lesswater69/ikoka-stick-meshtastic-device/ikoka-stick-meshtastic-device.kicad_pcb

## KiCad design ikoka-stick-meshtastic-device.kicad_pcb (2025-10-22)

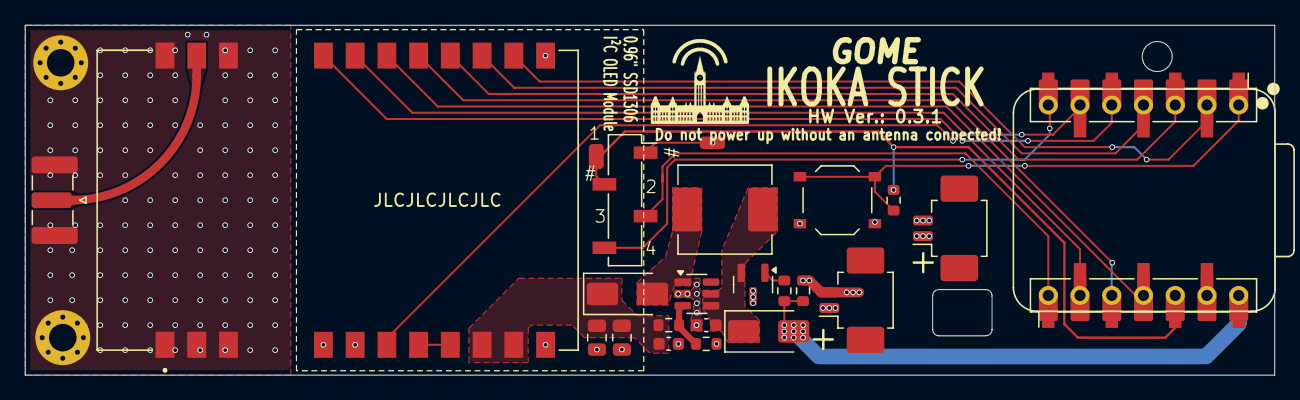
[picture p1: board ikoka-stick-meshtastic-device.kicad_pcb from above]

Board: 2 copper layers, 100.0 x 28.0 mm, 27 parts (1 on the bottom side), 22 nets.

Parts:
BT1: Battery_Cell; BatteryHolder_MYOUNG_BH-21700-B1BJ001_1x21700
C1, C2: 22uF; C_0603_1608Metric
C3, C4: 47uF; C_0805_2012Metric
D1, D3: SS34; D_SMA
H1, H2: MountingHole; MountingHole_2.2mm_M2_Pad_Via
J1: Conn_Coaxial; SMA_Samtec_SMA-J-P-H-ST-EM1_EdgeMount
J2, J3: Conn_01x07_Socket; PinSocket_1x07_P2.54mm_Vertical_SMD_Pin1Left
J4, J5: Conn_01x02; Molex_PicoBlade_53261-0271_1x02-1MP_P1.25mm_Horizontal
J6: Conn_01x04; PinSocket_1x04_P2.54mm_Vertical_SMD_Pin1Right
L1: 22uH; L_Sunlord_MWSA0624S
Q1: AO3401A; SOT-23
R1: 300K; R_0603_1608Metric
R2: 39K; R_0603_1608Metric
R3, R5: 100k; R_0603_1608Metric
R4: 1k; R_0603_1608Metric
SW1: SW_Push; SW_Push_1P1T_XKB_TS-1187A
U1: MT3608; SOT-23-6
U2: E22-900M30S; XCVR_E22-900M30S
U3: XIAO-ESP32-S3-SMD; XIAO-ESP32S3-DIP
pin1: SolderWirePad_1x01_SMD_1.5x3mm

Connections:
+3V3: J3.5, J6.2, R5.1, U3.12 (VCC_3V3), pin1.1
+5V: D3.2 (A), J3.7, R3.1, R4.1, U3.14 (VBUS)
+5V2_LORA: C2.1, C3.1, C4.1, D1.1 (K), R1.1, U2.9 (VCC), U2.10 (VCC)
+BATT: BT1.1 (+), J4.1, J5.1, Q1.3 (D)
/ANT: J1.1 (In), U2.21 (ANT)
/BOOST_IN: C1.1, D3.1 (K), L1.2, Q1.2 (S), U1.4 (EN), U1.5 (IN)
/D0: J2.1, R5.2, SW1.1, U3.1 (GPIO1/D0/A0)
/I2C_SCL: J3.1, J6.3, U3.8 (U0RXD/D7/RX)
/I2C_SDA: J2.7, J6.4, U3.7 (U0TXD/D6/TX)
/LORA_BUSY: J2.4, U2.14 (BUSY), U3.4 (GPIO4/D3/A3)
/LORA_DIO1: J2.2, U2.13 (DIO1), U3.2 (GPIO2/DA/A1)
/LORA_RST: J2.3, U2.15 (~RST), U3.3 (GPIO3/D2/A2)
/LORA_RXEN: J2.6, U2.6 (RXEN), U3.6 (GPIO9/D5/I2C_SCL)
/LORA_SPI_MISO: J3.3, U2.16 (MISO), U3.10 (GPIO8/D9/A9/MISO)
/LORA_SPI_MOSI: J3.4, U2.17 (MOSI), U3.11 (GPIO9/D10/A10/MOSI)
/LORA_SPI_NSS: J2.5, U2.19 (NSS), U3.5 (GPIO5/D4/I2C_SDA)
/LORA_SPI_SCK: J3.2, U2.18 (SCK), U3.9 (GPIO7/D8/A8/SCK)
GND: BT1.2 (-), C1.2, C2.2, C3.2, C4.2, H1.1, H2.1, J1.2 (Ext), J3.6, J4.2, J5.2, J6.1, R2.2, R3.2, SW1.2, U1.2 (GND), U2.1 (GND), U2.2 (GND), U2.3 (GND), U2.4 (GND), U2.5 (GND), U2.11 (GND), U2.12 (GND), U2.20 (GND), U2.22 (GND), U3.13 (GND)
unnamed: D1.2 (A), L1.1, U1.1 (SW)
unnamed: Q1.1 (G), R4.2
unnamed: R1.2, R2.1, U1.3 (FB)
unnamed: U2.7 (TXEN), U2.8 (DIO2)
