lesswater69/ikoka-stick-meshtastic-device/(commit log)

2025-10-02 Update ikoka-stick-meshtastic-device.kicad_pcb
    Silk screen edits to improve polarity awarness
    [ikoka-stick-meshtastic-device.kicad_pcb]
2025-10-02 kicad export with silk screen changes
    [BOM-ikoka-stick-meshtastic-device.csv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]
2025-10-21 rotation of q1,j1,j2,j3,j6 and bt1 adjustment
    [CPL-ikoka-stick-meshtastic-device.csv]
2025-10-22 version update, oled pinout silk
    [ikoka-stick-meshtastic-device.kicad_pcb]
